ddanila/Pico1715/README.md

# Pico1715

An independent Pico-based replacement/expansion card for the Robotron PC 1715:
SD-backed virtual floppies, external RAM and a buffered X2 bus interface.
Original project code and design files are MIT licensed; see [LICENSE](LICENSE).

Configurable [compact triggers and rolling history](docs/analyzer-triggers.md) now
support event/address/data matching, bounded pre/post windows and USB download.

## Status

The scheduled-byte card model boots the unchanged classic ROM into SCP 0006 and
passes nine software regressions plus 36 latency/fault experiments.
See the [timing results](docs/timing-contract.md) and
[hardware requirements derived from them](hardware/timing-requirements.md).
The FPGA normal-I/O and interrupt frontend now passes all nine ROM/OS cases
in RTL co-simulation, including a shared-firmware profile with journaled SD
writeback. A 59-pin Olimex HX8K bench target is placed and routed,
and Pico Plus 2 firmware builds with PSRAM, SD CRC checking and optional journaled
writeback. See the [prototype build, wiring and parts guide](hardware/prototype.md).

**Bench prototype, not ready to manufacture:** no firmware has run on hardware,
no X2 electrical measurements have been made, and no qualified PCB exists.
The firmware co-simulator compiles the same service loop and journal code for
host execution and connects them to the board-level RTL. GPIO, time, PSRAM and
SD blocks are simulated; this does not execute RP2350 instructions or qualify
physical timing. See [firmware co-simulation](docs/firmware-cosim.md) and
[delayed storage, reset and recovery qualification](docs/firmware-storage-faults.md).

The standalone [analyzer transport](docs/analyzer-transport.md) now joins passive
FPGA cycle capture to a CRC-protected Pico link and a bounded 7 MiB PSRAM buffer.
Shared-firmware/RTL tests cover stalls, corruption, retry and buffer exhaustion;
stock-boot replay retains all 215,848 selected records. [USB control/download](docs/analyzer-usb.md)
now provides explicit arm/stop and validated capture files through a Python host
utility. A separate [passive analyzer adapter](hardware/analyzer-interface/README.md)
now has a checked schematic, full input harness and routed HX8K bitstream.
A [combined carrier schematic](hardware/carrier/README.md) now provides one
wiring contract for both personalities, a physical passive-mode interlock,
Pico power isolation, SD and button/SAFE-LED support. Both new FPGA targets route
with passing internal timing. Physical assembly, USB/timing qualification and
PCB layout remain open.

An experimental third [combined controller/capture personality](docs/combined-mode.md)
now runs disk service and finite analyzer capture concurrently. Classic CP/M guest
write/cold-read tests preserve existing files, and the HX8K build meets its
internal clock constraints. Capture loss under load is explicitly reported.
The optional [reserve supervisor](docs/reserve-interface.md) uses PIM724 SP/CE
GPIO32/33/36 and defaults to zero qualified energy. See the
[Rev A order gates](docs/rev-a-release.md) for remaining PCB work.

The first compatibility target is the **ordinary PC 1715**, retaining its boot
ROM and operating-system floppy routines. It must not be confused with the
**1715W/M**: the existing DAC emulator and available S550/TOS/M reference boot
exercise the latter's 8272-based controller. They are useful infrastructure,
not evidence that the ordinary 1715 controller has been implemented.
The owner's MB001 inventory identifies an ordinary 1715. Its board revision,
connector orientation and electrical behavior still require physical verification.

## Run the existing emulator baseline

Requirements: Python 3.10+, a C11 compiler, Git, and the external
[dac-emulation](https://github.com/ddanila/dac-emulation) checkout at the revision
recorded in [sources.json](docs/sources.json). No Python packages are required.

```sh
python3 tools/capture_dac.py \
  --dac ../dac-emulation \
  --rom ../dac/public/media/robotron/s550.bin \
  --prom ../dac/public/media/robotron/cas.bin \
  --disk ../dac/public/media/robotron/tosm10.img \
  --out local/wm-baseline
python3 -m unittest discover -s tests -v
```

The tool builds its adapter and the external emulator in this project's ignored
`build/` directory. It requires the pinned revision and clean tracked dependency
files. Inputs are read-only; the output directory must not already exist.
It records input hashes, emulator identity, I/O and interrupt-acknowledge events,
a text screen, and a report. It exits unsuccessfully if the boot prompt is absent,
inputs change, or the trace is truncated. ROM and disk contents are not committed.
Even the local trace can contain guest data: it stays ignored by default.

This is an **observational W/M baseline**, not co-simulation with Pico1715.
Read/write events can repeat on consecutive emulated CPU ticks; they are not
necessarily distinct bus transactions. Timestamps are emulator scheduling ticks,
not qualified physical X2 signal edges.

[Controller USB](docs/controller-usb.md) provides status and safe eject without
a debugger, including initialization/storage diagnostics and a host CLI.

## Next milestones

The [roadmap](docs/roadmap.md) separates implemented desk work from hardware
qualification. Safe eject/reserve-aware shutdown, motherboard interrupt-chain
modelling, firmware cost/fault tests, and controller USB status/eject are implemented
and tested within their documented simulation limits.

Analyzer capture, filtering, triggers, PSRAM transport, USB download and decoding
are also implemented. The [combined carrier](hardware/carrier/README.md) has checked
controller/analyzer FPGA personalities and a physical passive-mode interlock.
[Remote-reset software](docs/analyzer-reset.md) exists for the optional standalone
accessory; that accessory remains electrically unqualified and is disabled on the
combined carrier because GP22 serves SD chip select. X1/X2's reset contact alone
does not reset the CPU on the documented motherboard.

The [carrier layout](hardware/carrier/mechanics.md) now has local bypass placement,
2,206 routed segments, 426 vias and ground pours on both copper layers. All placed
non-SD terminals are connected. KiCad DRC reports zero violations and **12 open
connections, all involving the held SD socket**. X2 remains unplaced. See the
[routing evidence](hardware/carrier/routing.md). This is not a fabrication release;
SD/X2 geometry, return-path and timing review, optional backup power, broader OS
coverage and physical tests remain open.

Physical milestones remain:

1. Assemble the selected bench modules and verify PSRAM, SD and FPGA programming.
2. Measure worst-case Pico mailbox latency and translated bus timing on a fixture.
3. Verify X2 orientation, priority-chain wiring and mechanics on the actual 1715;
   boot the unchanged ROM and repeat the read/write/persistence tests.
4. Freeze the schematic, route the PCB, run ERC/DRC, and review manufacturing
   outputs; qualify assembled prototypes before declaring RTM.

See [hardware requirements](hardware/requirements.md),
[modelling plan](docs/modelling.md), [classic controller contract](docs/classic-controller.md)
and [licensing/provenance](NOTICE.md). The initial passing W/M run is recorded in
[reports/wm-baseline.json](reports/wm-baseline.json); local reference identities
are listed in [docs/local-evidence.json](docs/local-evidence.json).

## Plain PC1715 model

The pinned DAC revision supplies `machines/robotron1715` (runtime kind 3) with
64 KB RAM, the original ROM overlay and native card callbacks. This repository's
`model/controller.c` attaches to it without changing the emulator or guest code.
The runner enables onboard CTC/SIO, feeds completed keyboard bytes into the SIO
receive FIFO and reads the text screen from RAM. See the
[stock-software qualification](docs/onboard-keyboard.md). Production firmware
uses a bounded [two-byte receive queue](docs/receive-elasticity.md) to handle
index/mark interrupt overlap; the standalone reference model defaults to one byte.
[Service-cost tests](docs/service-costs.md) now cover processing stalls, shared-lock
contention, watchdog release and recovery during SD writeback.
[Stock Z80 cost experiments](docs/cpu-service-costs.md) combine these delays with
boot, BDOS and persistence checks, preserving both passing and overloaded profiles.
[Receive read-ahead](docs/read-ahead.md) moves byte preparation into idle mailbox
time while retaining the same two-byte capacity.
[Transmit staging](docs/transmit-staging.md) acknowledges bounded byte capture
before processing, preserving serializer deadlines and CRC validation.
[Combined stress](docs/combined-stress.md) adds deterministic processing bursts,
variable SD write latency and index-interrupt offsets, with overload and remount checks.
[Interrupt fault isolation](docs/interrupt-fault-isolation.md) releases failed
controller IRQ ownership and bypasses the chain until reset.

```sh
make test
python3 tools/check_classic.py \
  --dac ../dac-emulation \
  --rom /path/r1715bt.bin \
  --disk /path/r1715.cpm \
  --out local/classic-check
```

The checker requires the ROM and SCP image hashes recorded in
[local-evidence.json](docs/local-evidence.json), and a fresh output directory.
Inputs are read-only; writes affect disposable copies. It tests original-image
boot/DIR, SAVE, persistence, a disk-loaded BDOS read/write workload, TYPE after
cold boot, deletion/persistence, write protection, and absent media. Model-only
contract tests also cover malformed writes and interrupt/reset behavior.

See [reports/classic-compatibility.json](reports/classic-compatibility.json) and
[the controller contract and remaining gaps](docs/classic-controller.md).
Use `--timed` for scheduled bytes, or `tools/check_timing.py` with the same
arguments for the full timing suite.
**Scheduled bytes are not an electrically qualified hardware design.** Generic
PIO modes, full motherboard peripherals, other formats and physical bus behavior
remain outside this qualification.

## Bench adapter and fixture

The [buffered adapter schematic](hardware/interface/README.md) includes hardware
output gating and dual-rail supervision. The [standalone FPGA/Pico fixture](hardware/bench-fixture.md)
checks 515 mailbox transactions, IRQ/vector/RETI and returns a UART result.
Both are bench artifacts: [X2 common contacts](hardware/x2-pinout.md) are now
source-checked and assigned, including original-controller IRQ direction. Physical
validation and connector footprint selection remain pending.

The [four-contact EFS test fixture](hardware/efs58-coupon/README.md) provides
printed holder STL/STEP files, a routed passive breakout PCB and fabrication
files. It lets us screen a modern loose socket before committing to a full
58-contact replacement. Mating fit still requires sacrificial-contact trials.

## Prototype validation

```sh
make test test-store test-frontend test-irq test-pico-top lint-frontend
python3 tools/check_classic.py --cosim --dac ../dac-emulation \
  --rom /path/r1715bt.bin --disk /path/r1715.cpm --out local/rtl-check
```

RTL co-simulation requires Verilator and a C++ compiler. See
[reports/rtl-compatibility.json](reports/rtl-compatibility.json) for the nine-case
result and source hashes, and [the prototype guide](hardware/prototype.md) for
FPGA and firmware builds. ROMs and disk images remain external.

The [classic 1715 trace decoder](docs/analyzer-decoder.md) provides controller
timelines, field CRC checks, configurable WAIT/gap diagnostics and reference
comparison for downloaded compact captures.

[Safe eject and shutdown](docs/shutdown.md) now drain the journal before reporting
safe, with optional reserve-gated writeback and deterministic outage tests.

[Motherboard interrupt-chain tests](docs/motherboard-interrupts.md) now exercise
the real controller with CTC/SIO priority, IM2 vectors, RETI and card isolation.

The latest [desk-work pass](docs/desk-completion.md) adds a provisional routed
58-contact X2 breakout, assembly/probe documentation, return-path screening with
23 extra ground stitches, and a 30-case external-media survey/persistence suite.
The separate [four-layer Rev A](hardware/carrier-reva/README.md) now uses the
drawing-checked Würth SD socket and host header, with zero ERC/DRC violations
and zero opens. Return-path closure, final manufacturing review, actual connector
fit and hardware qualification remain open.

Further desk work now includes [W-loader diagnosis](docs/boot-image-diagnosis.md),
[indexed multi-extent and disk-full tests](docs/pattern-media.md) on native and
shared-firmware/FPGA backends, and an [optional reserve-power schematic](hardware/backup-power/README.md).
The reserve remains a draft with no GPIO integration or measured hold-up guarantee.

The [browser workstation](docs/browser-workstation.md) builds model and firmware/RTL
WebAssembly sessions for the classic-1715 DAC museum exhibit.

[Session capture](docs/session-capture.md) connects both emulator backends to the
workbench. The [guided bring-up runner](docs/bringup-runner.md) collects staged,
hash-bound evidence; simulated rehearsal never qualifies hardware.
