ddanila/Pico1715/docs/modelling.md

# Modelling Pico1715

## Plain PC1715 integration

The pinned DAC revision provides `machines/robotron1715`: a headless Z80,
64 KB RAM, a 2 KB read-only ROM overlay with writes reaching underlying RAM,
and an external-card callback interface. Pico1715's `model/controller.c`
implements the card through that interface. It receives full I/O addresses,
read/write cycles, ticks, reset, IRQ acknowledgement and RETI, but has no access
to guest memory or instruction addresses. DAC now also supplies a deferred-I/O callback for transaction waits.

`tools/classic_probe.c` composes that motherboard with the card and a minimal
completed-byte keyboard source. Onboard CTC/SIO are enabled; E0/ASCII bytes
enter the real modeled receive FIFO, and guest code owns status, register setup
and data reads. See [the keyboard migration](onboard-keyboard.md). The
runner observes this SCP revision's screen RAM at F800h. It never patches guest
instructions, injects return values into registers, or bypasses BIOS/BDOS calls.
It records controller reads/writes/interrupt acknowledgements, exports a separate
disk copy, and captures RAM for inspection. Outputs use exclusive file creation.

`tools/check_classic.py` enforces the pinned clean DAC revision and exact ROM/SCP
hashes. Nine scenarios cover cold boot/DIR, SAVE, saved-file persistence, a
2,560-byte BDOS write/read/compare, TYPE after cold boot, deletion and its
persistence, write protection, and absent media. All writes use private copies.
It verifies hashes and independently parses the created files; a successful
process exit or an observed ROM jump alone is not the acceptance criterion.
See [the onboard-peripheral report](../reports/onboard-classic.json) and
[controller contract](classic-controller.md).

## Scheduled timing and its limits

The optional timed profile independently clocks receive and transmit bytes,
implements register backpressure through DAC transaction waits, and exposes
lost-byte/CRC/delay/reset faults. All nine scenarios pass in timed mode. See the
[timing contract](timing-contract.md) for evidence, 36 experiments, exact delay
semantics and remaining limitations.

Legacy functional mode remains a demand-driven comparison. Neither mode is a
flux or full PIO simulation. Field acquisition is synthetic, valid writes update
sectors atomically, and the WAIT adapter cannot qualify physical sampling edges.
SIO/CTC/CRT are not fully modelled. External-memory inhibition and DMA are not
implemented on the plain card seam. Connector identity, voltage translation,
power sequencing and physical bus timing remain separate qualification gates.

## Shared firmware and board-level RTL

The `--firmware-cosim` profile connects the production `firmware/service.c` and
`firmware/store.c` to the actual `pico1715_top` RTL, including the bidirectional
mailbox, vector mirrors, IRQ/RETI toggles and backend-ready gating. A host HAL
supplies GPIO, clock, PSRAM and SD blocks. See [the execution boundary, evidence
and reproduction commands](firmware-cosim.md). This closes the direct C-backend
bypass in the earlier RTL profile; it does not emulate the RP2350 instruction set.

## W/M baseline remains separate

`tools/dac_capture.c` observes the existing `robotron1715m` model running S550 and
TOS/M. The wrapper `tools/capture_dac.py` verifies dependency identity and input
hashes and records CPU/DMA-aware traces. This uses the W/M 8272 controller and
cannot validate the ordinary 1715's custom two-PIO controller.

The earlier [classic startup report](../reports/classic-startup.json) is retained
as a no-controller negative baseline. It reaches the ROM's controller-ready wait;
[the newer compatibility report](../reports/classic-compatibility.json) supplies
the positive evidence with the functional card attached.
