ddanila/Pico1715/reports/carrier-reva-inspection/F_FAULT.png

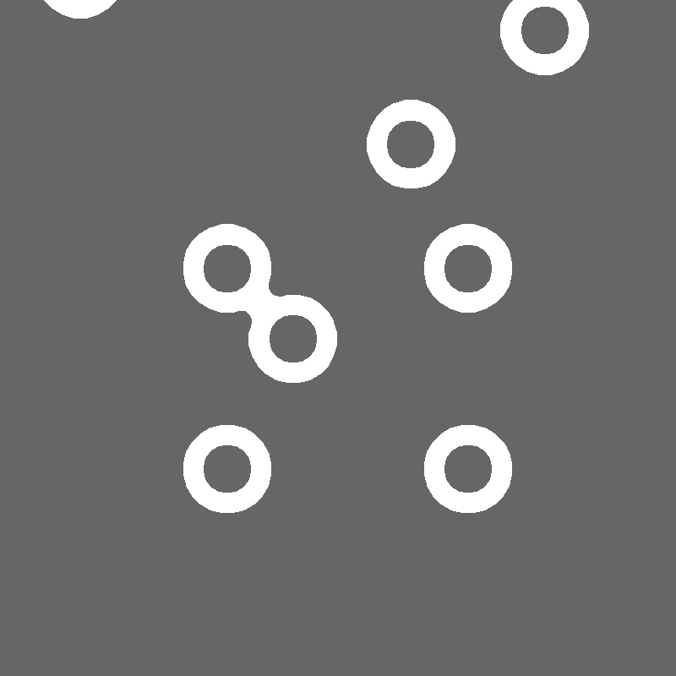
reports/carrier-reva-inspection/F_FAULT.png
