ddanila/Pico1715/reports/carrier-reva-inspection/F_WR_N.png

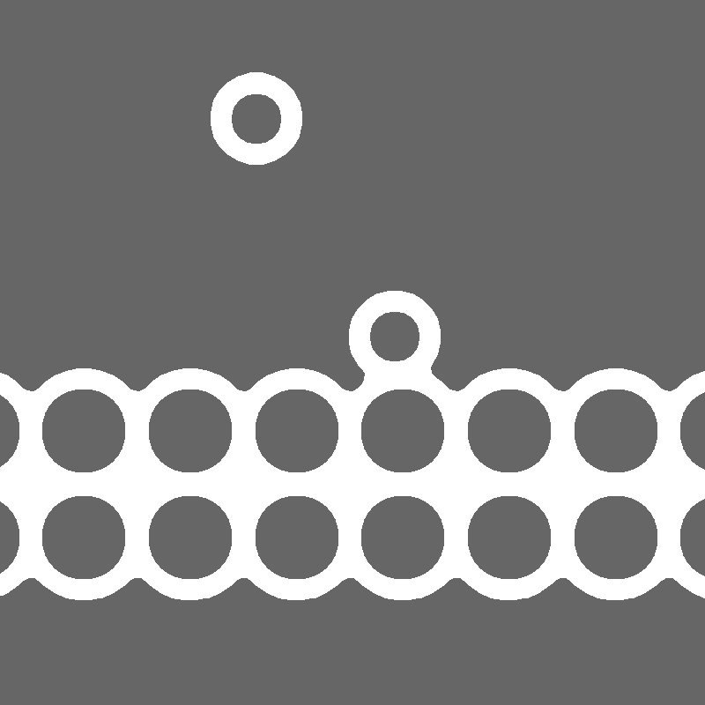
reports/carrier-reva-inspection/F_WR_N.png
