ddanila/Pico1715/reports/carrier-reva-inspection/P_VSYS.png

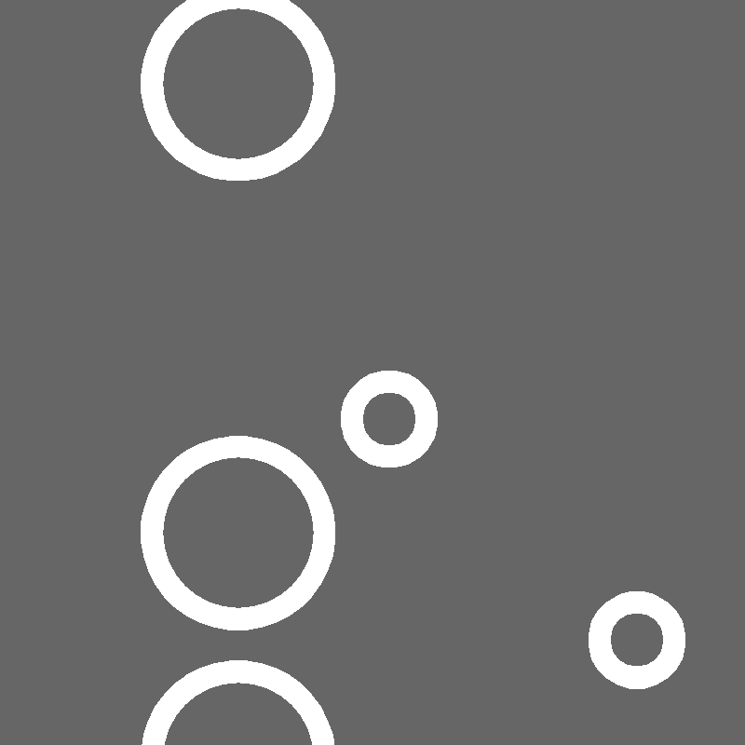
reports/carrier-reva-inspection/P_VSYS.png
