ddanila/Pico1715/reports/carrier-reva-inspection/SD_DAT1.png

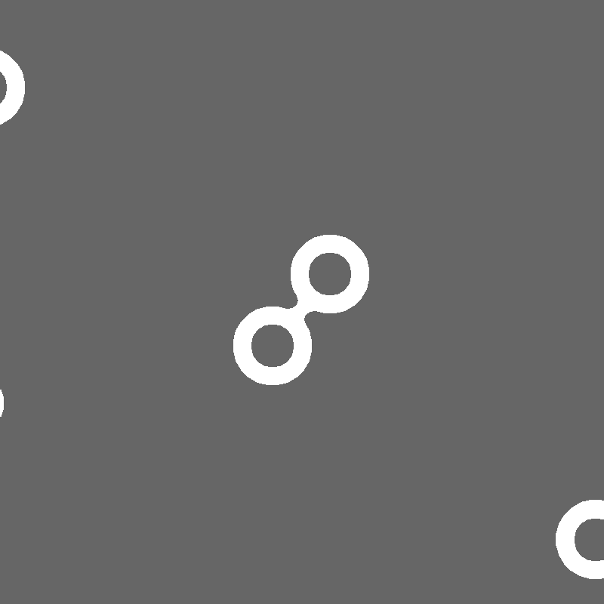
reports/carrier-reva-inspection/SD_DAT1.png
