ddanila/Pico1715/hardware/carrier-reva/bom.tsv

Reference | Value | Footprint | Datasheet
J6 | 61206021621_HOST_HARNESS | Pico1715_RevA:IDC_Wuerth_61206021621 | https://www.we-online.com/components/products/datasheet/61206021621.pdf
RX1 | SN74LVC541ADWR | Package_SO:SOIC-20W_7.5x12.8mm_P1.27mm | https://www.ti.com/lit/ds/symlink/sn74lvc541a.pdf
RX2 | SN74LVC541ADWR | Package_SO:SOIC-20W_7.5x12.8mm_P1.27mm | https://www.ti.com/lit/ds/symlink/sn74lvc541a.pdf
RX3 | SN74LVC541ADWR | Package_SO:SOIC-20W_7.5x12.8mm_P1.27mm | https://www.ti.com/lit/ds/symlink/sn74lvc541a.pdf
RX4 | SN74LVC541ADWR | Package_SO:SOIC-20W_7.5x12.8mm_P1.27mm | https://www.ti.com/lit/ds/symlink/sn74lvc541a.pdf
RX5 | SN74LVC541ADWR | Package_SO:SOIC-20W_7.5x12.8mm_P1.27mm | https://www.ti.com/lit/ds/symlink/sn74lvc541a.pdf
U4 | SN74AHCT541DWR | Package_SO:SOIC-20W_7.5x12.8mm_P1.27mm | https://www.ti.com/lit/ds/symlink/sn74ahct541.pdf
U5 | SN74AHCT1G125DBVR | Package_TO_SOT_SMD:SOT-23-5 | https://www.ti.com/lit/ds/symlink/sn74ahct1g125.pdf
U6 | SN74LVC08ADR | Package_SO:SOIC-14_3.9x8.7mm_P1.27mm | https://www.ti.com/lit/ds/symlink/sn74lvc08a.pdf
U7 | SN74LVC08ADR | Package_SO:SOIC-14_3.9x8.7mm_P1.27mm | https://www.ti.com/lit/ds/symlink/sn74lvc08a.pdf
U8 | SN74LVC00ADR | Package_SO:SOIC-14_3.9x8.7mm_P1.27mm | https://www.ti.com/lit/ds/symlink/sn74lvc00a.pdf
U13 | SN74LVC00ADR | Package_SO:SOIC-14_3.9x8.7mm_P1.27mm | https://www.ti.com/lit/ds/symlink/sn74lvc00a.pdf
U9 | SN74LVC07ADR | Package_SO:SOIC-14_3.9x8.7mm_P1.27mm | https://www.ti.com/lit/ds/symlink/sn74lvc07a.pdf
U10 | TLV803EA30DBZR | Package_TO_SOT_SMD:SOT-23 | https://www.ti.com/lit/ds/symlink/tlv803e.pdf
U11 | TLV803EA46DBZR | Package_TO_SOT_SMD:SOT-23 | https://www.ti.com/lit/ds/symlink/tlv803e.pdf
U12 | TLV803EA30DBZR | Package_TO_SOT_SMD:SOT-23 | https://www.ti.com/lit/ds/symlink/tlv803e.pdf
SW1 | JS202011JCQN | Pico1715_Carrier:JS202011JCQN_VendorPins | https://www.littelfuse.com/products/switches/slide-switches/js
ISO1 | SN74CB3Q3245PWR | Package_SO:TSSOP-20_4.4x6.5mm_P0.65mm | https://www.ti.com/lit/ds/symlink/sn74cb3q3245.pdf
ISO2 | SN74CB3Q3245PWR | Package_SO:TSSOP-20_4.4x6.5mm_P0.65mm | https://www.ti.com/lit/ds/symlink/sn74cb3q3245.pdf
ISO3 | SN74CB3Q3245PWR | Package_SO:TSSOP-20_4.4x6.5mm_P0.65mm | https://www.ti.com/lit/ds/symlink/sn74cb3q3245.pdf
EXT1 | OLIMEX_EXT1 | Connector_PinHeader_1.27mm:PinHeader_2x20_P1.27mm_Vertical | -
EXT2 | OLIMEX_EXT2 | Connector_PinHeader_1.27mm:PinHeader_2x20_P1.27mm_Vertical | -
EXT3 | OLIMEX_EXT3 | Connector_PinHeader_1.27mm:PinHeader_2x20_P1.27mm_Vertical | -
J1 | PGM1_PIN5_CDONE_TAP | Connector_PinHeader_2.54mm:PinHeader_1x02_P2.54mm_Vertical | -
J2 | PIM724_PICO_PLUS2 | Pico1715_Carrier:PIM724_SocketPair | https://shop.pimoroni.com/products/pimoroni-pico-plus-2
J3 | 693071010811 | Pico1715_RevA:microSD_Wuerth_693071010811 | https://www.we-online.com/components/products/datasheet/693071010811.pdf
J4 | REGULATED_5V_INPUT | Connector_JST:JST_XH_B2B-XH-A_1x02_P2.50mm_Vertical | -
D1 | SS14 | Diode_SMD:D_SMA | https://www.vishay.com/docs/88746/ss12.pdf
J5 | BRINGUP_PROBES | Connector_PinHeader_2.54mm:PinHeader_1x15_P2.54mm_Vertical | -
R1 | 2k2 | Resistor_SMD:R_0805_2012Metric | -
R2 | 22k | Resistor_SMD:R_0805_2012Metric | -
R3 | 2k2 | Resistor_SMD:R_0805_2012Metric | -
R4 | 22k | Resistor_SMD:R_0805_2012Metric | -
R5 | 2k2 | Resistor_SMD:R_0805_2012Metric | -
R6 | 22k | Resistor_SMD:R_0805_2012Metric | -
R7 | 4k7 | Resistor_SMD:R_0805_2012Metric | -
R8 | 4k7 | Resistor_SMD:R_0805_2012Metric | -
R9 | 4k7 | Resistor_SMD:R_0805_2012Metric | -
R10 | 4k7 | Resistor_SMD:R_0805_2012Metric | -
R11 | 4k7 | Resistor_SMD:R_0805_2012Metric | -
R12 | 4k7 | Resistor_SMD:R_0805_2012Metric | -
R13 | 4k7 | Resistor_SMD:R_0805_2012Metric | -
R14 | 1k | Resistor_SMD:R_0805_2012Metric | -
R15 | 1k | Resistor_SMD:R_0805_2012Metric | -
R16 | 100k | Resistor_SMD:R_0805_2012Metric | -
R17 | 4k7 | Resistor_SMD:R_0805_2012Metric | -
R18 | 10k | Resistor_SMD:R_0805_2012Metric | -
R19 | 4k7 | Resistor_SMD:R_0805_2012Metric | -
R20 | 4k7 | Resistor_SMD:R_0805_2012Metric | -
R21 | 4k7 | Resistor_SMD:R_0805_2012Metric | -
R22 | 47k | Resistor_SMD:R_0805_2012Metric | -
R23 | 47k | Resistor_SMD:R_0805_2012Metric | -
R24 | 47k | Resistor_SMD:R_0805_2012Metric | -
C1 | 100nF | Capacitor_SMD:C_0805_2012Metric | -
C2 | 100nF | Capacitor_SMD:C_0805_2012Metric | -
C3 | 100nF | Capacitor_SMD:C_0805_2012Metric | -
C4 | 100nF | Capacitor_SMD:C_0805_2012Metric | -
C5 | 100nF | Capacitor_SMD:C_0805_2012Metric | -
C6 | 100nF | Capacitor_SMD:C_0805_2012Metric | -
C7 | 100nF | Capacitor_SMD:C_0805_2012Metric | -
C8 | 100nF | Capacitor_SMD:C_0805_2012Metric | -
C9 | 100nF | Capacitor_SMD:C_0805_2012Metric | -
C10 | 100nF | Capacitor_SMD:C_0805_2012Metric | -
C11 | 100nF | Capacitor_SMD:C_0805_2012Metric | -
C12 | 100nF | Capacitor_SMD:C_0805_2012Metric | -
C13 | 100nF | Capacitor_SMD:C_0805_2012Metric | -
C14 | 100nF | Capacitor_SMD:C_0805_2012Metric | -
C15 | 100nF | Capacitor_SMD:C_0805_2012Metric | -
C16 | 100nF | Capacitor_SMD:C_0805_2012Metric | -
C17 | 100nF | Capacitor_SMD:C_0805_2012Metric | -
C18 | 100nF | Capacitor_SMD:C_0805_2012Metric | -
C19 | 100nF | Capacitor_SMD:C_0805_2012Metric | -
C20 | 10uF_10V | Capacitor_SMD:C_0805_2012Metric | -
C21 | 10uF_10V | Capacitor_SMD:C_0805_2012Metric | -
C22 | 10uF_10V | Capacitor_SMD:C_0805_2012Metric | -
J7 | B3B-XH-A_RESERVE_POWER | Connector_JST:JST_XH_B3B-XH-A_1x03_P2.50mm_Vertical | https://www.jst-mfg.com/product/index.php?series=277
