ddanila/Pico1715/hardware/analyzer-interface/bom.tsv

Reference | Value | Footprint | Datasheet
X2 | PC1715_X2_ANALYZER | - | -
U1 | SN74LVC541ADWR | Package_SO:SOIC-20W_7.5x12.8mm_P1.27mm | https://www.ti.com/lit/ds/symlink/sn74lvc541a.pdf
U2 | SN74LVC541ADWR | Package_SO:SOIC-20W_7.5x12.8mm_P1.27mm | https://www.ti.com/lit/ds/symlink/sn74lvc541a.pdf
U3 | SN74LVC541ADWR | Package_SO:SOIC-20W_7.5x12.8mm_P1.27mm | https://www.ti.com/lit/ds/symlink/sn74lvc541a.pdf
U4 | SN74LVC541ADWR | Package_SO:SOIC-20W_7.5x12.8mm_P1.27mm | https://www.ti.com/lit/ds/symlink/sn74lvc541a.pdf
U5 | SN74LVC541ADWR | Package_SO:SOIC-20W_7.5x12.8mm_P1.27mm | https://www.ti.com/lit/ds/symlink/sn74lvc541a.pdf
U6 | TLV803EA30DBZR | Package_TO_SOT_SMD:SOT-23 | https://www.ti.com/lit/ds/symlink/tlv803e.pdf
R1 | 0R | Resistor_SMD:R_0805_2012Metric | -
R2 | 10k | Resistor_SMD:R_0805_2012Metric | -
R3 | 2k2 | Resistor_SMD:R_0805_2012Metric | -
R4 | 22k | Resistor_SMD:R_0805_2012Metric | -
R5 | 4k7 | Resistor_SMD:R_0805_2012Metric | -
R6 | 4k7 | Resistor_SMD:R_0805_2012Metric | -
R7 | 4k7 | Resistor_SMD:R_0805_2012Metric | -
R8 | 4k7 | Resistor_SMD:R_0805_2012Metric | -
C1 | 100nF | Capacitor_SMD:C_0805_2012Metric | -
C2 | 100nF | Capacitor_SMD:C_0805_2012Metric | -
C3 | 100nF | Capacitor_SMD:C_0805_2012Metric | -
C4 | 100nF | Capacitor_SMD:C_0805_2012Metric | -
C5 | 100nF | Capacitor_SMD:C_0805_2012Metric | -
C6 | 100nF | Capacitor_SMD:C_0805_2012Metric | -
EXT1 | OLIMEX_EXT1 | - | -
EXT2 | OLIMEX_EXT2 | - | -
EXT3 | OLIMEX_EXT3 | - | -
J1 | PICO_GPIO_LOGICAL | - | -
J2 | FPGA_3V3_POWER | - | -
