ddanila/Pico1715/hardware/interface/bom.tsv

Reference | Value | Footprint | Datasheet
U1 | SN74LVC245ADWR | Package_SO:SOIC-20W_7.5x12.8mm_P1.27mm | https://www.ti.com/lit/ds/symlink/sn74lvc245a.pdf
U2 | SN74LVC245ADWR | Package_SO:SOIC-20W_7.5x12.8mm_P1.27mm | https://www.ti.com/lit/ds/symlink/sn74lvc245a.pdf
U3 | SN74LVC245ADWR | Package_SO:SOIC-20W_7.5x12.8mm_P1.27mm | https://www.ti.com/lit/ds/symlink/sn74lvc245a.pdf
U4 | SN74AHCT541DWR | Package_SO:SOIC-20W_7.5x12.8mm_P1.27mm | https://www.ti.com/lit/ds/symlink/sn74ahct541.pdf
U5 | SN74AHCT1G125DBVR | Package_TO_SOT_SMD:SOT-23-5 | https://www.ti.com/lit/ds/symlink/sn74ahct1g125.pdf
U6 | SN74LVC08ADR | Package_SO:SOIC-14_3.9x8.7mm_P1.27mm | https://www.ti.com/lit/ds/symlink/sn74lvc08a.pdf
U7 | SN74LVC08ADR | Package_SO:SOIC-14_3.9x8.7mm_P1.27mm | https://www.ti.com/lit/ds/symlink/sn74lvc08a.pdf
U8 | SN74LVC00ADR | Package_SO:SOIC-14_3.9x8.7mm_P1.27mm | https://www.ti.com/lit/ds/symlink/sn74lvc00a.pdf
U9 | SN74LVC07ADR | Package_SO:SOIC-14_3.9x8.7mm_P1.27mm | https://www.ti.com/lit/ds/symlink/sn74lvc07a.pdf
U10 | TLV803EA30DBZR | Package_TO_SOT_SMD:SOT-23 | https://www.ti.com/lit/ds/symlink/tlv803e.pdf
U11 | TLV803EA46DBZR | Package_TO_SOT_SMD:SOT-23 | https://www.ti.com/lit/ds/symlink/tlv803e.pdf
J1 | HOST_ADDRESS | - | -
J2 | HOST_DATA | - | -
J3 | HOST_CONTROL | - | -
J4 | FPGA_ADDRESS | - | -
J5 | FPGA_DATA_IN | - | -
J6 | FPGA_DATA_OUT | - | -
J7 | FPGA_CONTROL | - | -
J8 | QUALIFIERS | - | -
J9 | EXTERNAL_RAILS | - | -
JP1 | ARM_SHUNT | - | -
J10 | SCOPE | - | -
X2 | PC1715_X2 | - | -
J11 | IRQ_PATCH | - | -
R15 | 10k | Resistor_SMD:R_0805_2012Metric | -
R16 | 0R | Resistor_SMD:R_0805_2012Metric | -
R17 | 0R | Resistor_SMD:R_0805_2012Metric | -
R1 | 2k2 | Resistor_SMD:R_0805_2012Metric | -
R2 | 22k | Resistor_SMD:R_0805_2012Metric | -
R3 | 2k2 | Resistor_SMD:R_0805_2012Metric | -
R4 | 22k | Resistor_SMD:R_0805_2012Metric | -
R5 | 1k | Resistor_SMD:R_0805_2012Metric | -
R6 | 1k | Resistor_SMD:R_0805_2012Metric | -
R7 | 4k7 | Resistor_SMD:R_0805_2012Metric | -
R8 | 4k7 | Resistor_SMD:R_0805_2012Metric | -
R9 | 4k7 | Resistor_SMD:R_0805_2012Metric | -
R10 | 4k7 | Resistor_SMD:R_0805_2012Metric | -
R11 | 4k7 | Resistor_SMD:R_0805_2012Metric | -
R12 | 4k7 | Resistor_SMD:R_0805_2012Metric | -
R13 | 4k7 | Resistor_SMD:R_0805_2012Metric | -
R14 | 4k7 | Resistor_SMD:R_0805_2012Metric | -
C1 | 100nF | Capacitor_SMD:C_0805_2012Metric | -
C2 | 100nF | Capacitor_SMD:C_0805_2012Metric | -
C3 | 100nF | Capacitor_SMD:C_0805_2012Metric | -
C4 | 100nF | Capacitor_SMD:C_0805_2012Metric | -
C5 | 100nF | Capacitor_SMD:C_0805_2012Metric | -
C6 | 100nF | Capacitor_SMD:C_0805_2012Metric | -
C7 | 100nF | Capacitor_SMD:C_0805_2012Metric | -
C8 | 100nF | Capacitor_SMD:C_0805_2012Metric | -
C9 | 100nF | Capacitor_SMD:C_0805_2012Metric | -
C10 | 100nF | Capacitor_SMD:C_0805_2012Metric | -
C11 | 100nF | Capacitor_SMD:C_0805_2012Metric | -
