ddanila/Pico1715/hardware/efs58-coupon/assembly.step

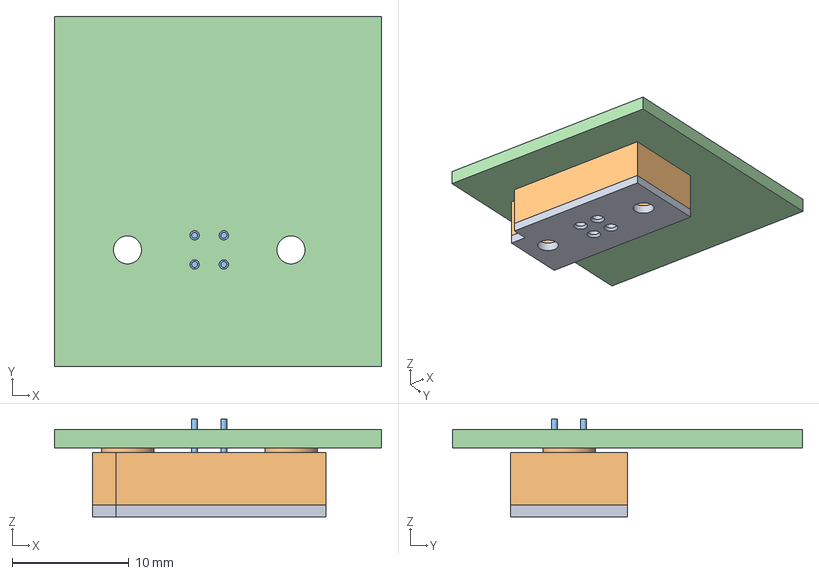
[picture p5: CAD file, 2026-10-26]
hardware/efs58-coupon/assembly.step
28.0 x 30.0 x 8.37 mm
