ddanila/Pico1715/hardware/efs58-coupon/front.step

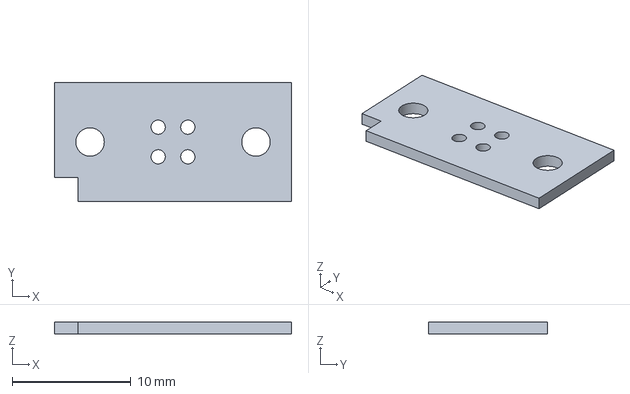
[picture p7: CAD file, 2026-10-26]
hardware/efs58-coupon/front.step
20.0 x 10.0 x 1.00 mm
