ddanila/Pico1715/hardware/efs58-coupon/body_c35.step

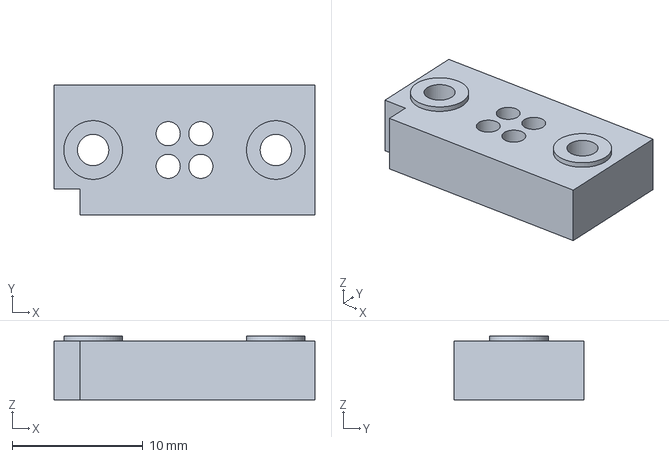
[picture p8: CAD file, 2026-10-26]
hardware/efs58-coupon/body_c35.step
20.0 x 10.0 x 4.90 mm
