ddanila/Pico1715/(list of files, cad)

Other CAD files:
hardware/efs58-coupon/body_c15.step
hardware/efs58-coupon/body_c15.stl
hardware/efs58-coupon/body_c25.stl
hardware/efs58-coupon/body_c35.stl
hardware/efs58-coupon/front.stl
