ddanila/Pico1715/(list of files, drawings)

Other design files:
hardware/carrier-reva/pcb-review.json
hardware/carrier/pcb-placement.json
