ddanila/Pico1715/hardware/carrier-reva/carrier.kicad_pcb

## KiCad design hardware/carrier-reva/carrier.kicad_pcb (2026-10-28)

Schematic: carrier.kicad_sch

Parts:
C1, C2, C3, C4, C5, C6, C7, C8, C9, C10, C11, C12, C13, C14, C15, C16, C17, C18, C19: 100nF; C_0805_2012Metric
C20, C21, C22: 10uF_10V; C_0805_2012Metric
D1: SS14; D_SMA
EXT1: OLIMEX_EXT1; PinHeader_2x20_P1.27mm_Vertical
EXT2: OLIMEX_EXT2; PinHeader_2x20_P1.27mm_Vertical
EXT3: OLIMEX_EXT3; PinHeader_2x20_P1.27mm_Vertical
ISO1, ISO2, ISO3: SN74CB3Q3245PWR; TSSOP-20_4.4x6.5mm_P0.65mm
J1: PGM1_PIN5_CDONE_TAP; PinHeader_1x02_P2.54mm_Vertical
J2: PIM724_PICO_PLUS2; PIM724_SocketPair
J3: 693071010811; microSD_Wuerth_693071010811
J4: REGULATED_5V_INPUT; JST_XH_B2B-XH-A_1x02_P2.50mm_Vertical
J5: BRINGUP_PROBES; PinHeader_1x15_P2.54mm_Vertical
J6: 61206021621_HOST_HARNESS; IDC_Wuerth_61206021621
J7: B3B-XH-A_RESERVE_POWER; JST_XH_B3B-XH-A_1x03_P2.50mm_Vertical
R1, R3, R5: 2k2; R_0805_2012Metric
R2, R4, R6: 22k; R_0805_2012Metric
R7, R8, R9, R10, R11, R12, R13, R17, R19, R20, R21: 4k7; R_0805_2012Metric
R14, R15: 1k; R_0805_2012Metric
R16: 100k; R_0805_2012Metric
R18: 10k; R_0805_2012Metric
R22, R23, R24: 47k; R_0805_2012Metric
RX1, RX2, RX3, RX4, RX5: SN74LVC541ADWR; SOIC-20W_7.5x12.8mm_P1.27mm
SW1: JS202011JCQN; JS202011JCQN_VendorPins
U4: SN74AHCT541DWR; SOIC-20W_7.5x12.8mm_P1.27mm
U5: SN74AHCT1G125DBVR; SOT-23-5
U6, U7: SN74LVC08ADR; SOIC-14_3.9x8.7mm_P1.27mm
U8, U13: SN74LVC00ADR; SOIC-14_3.9x8.7mm_P1.27mm
U9: SN74LVC07ADR; SOIC-14_3.9x8.7mm_P1.27mm
U10, U12: TLV803EA30DBZR; SOT-23
U11: TLV803EA46DBZR; SOT-23

Connections:
/ARMED: J5.9 (ARMED), U7.11 (4Y), U8.1 (1A), U8.4 (2A), U8.9 (3A), U8.12 (4A), U8.13 (4B)
/BACKEND_OK: U7.6 (2Y), U7.9 (3A)
/CDONE: J1.1 (CDONE_FROM_PGM1_5), J5.5 (CDONE), R16.1, U6.10 (3B)
/DATA_EN_N: U8.3 (1Y), U9.1 (1A)
/DATA_OE_N: J5.10 (DATA_OE_N), R14.2, U4.19 (OE2_N), U9.2 (1Y)
/DRIVEN_IEO: SW1.7 (CONTROLLER_IEO), U5.4 (Y)
/F_A0: EXT1.7 (F_A0), RX1.18 (Y0)
/F_A1: EXT1.9 (F_A1), RX1.17 (Y1)
/F_A2: EXT1.11 (F_A2), RX1.16 (Y2)
/F_A3: EXT1.13 (F_A3), RX1.15 (Y3)
/F_A4: EXT1.15 (F_A4), RX1.14 (Y4)
/F_A5: EXT1.17 (F_A5), RX1.13 (Y5)
/F_A6: EXT1.19 (F_A6), RX1.12 (Y6)
/F_A7: EXT1.21 (F_A7), RX1.11 (Y7)
/F_A8: EXT2.15 (F_A8), RX2.18 (Y0)
/F_A9: EXT2.17 (F_A9), RX2.17 (Y1)
/F_A10: EXT2.19 (F_A10), RX2.16 (Y2)
/F_A11: EXT2.21 (F_A11), RX2.15 (Y3)
/F_A12: EXT2.23 (F_A12), RX2.14 (Y4)
/F_A13: EXT2.25 (F_A13), RX2.13 (Y5)
/F_A14: EXT2.27 (F_A14), RX2.12 (Y6)
/F_A15: EXT2.29 (F_A15), RX2.11 (Y7)
/F_BAO_N: EXT2.40 (F_BAO_N), RX5.15 (Y3)
/F_BUSRQ_N: EXT2.39 (F_BUSRQ_N), RX5.16 (Y2)
/F_CLK: EXT2.33 (F_CLK), RX4.12 (Y6)
/F_D0: EXT1.23 (F_D0), RX3.18 (Y0)
/F_D1: EXT1.25 (F_D1), RX3.17 (Y1)
/F_D2: EXT1.27 (F_D2), RX3.16 (Y2)
/F_D3: EXT1.29 (F_D3), RX3.15 (Y3)
/F_D4: EXT1.31 (F_D4), RX3.14 (Y4)
/F_D5: EXT1.33 (F_D5), RX3.13 (Y5)
/F_D6: EXT1.35 (F_D6), RX3.12 (Y6)
/F_D7: EXT1.37 (F_D7), RX3.11 (Y7)
/F_DO0: EXT1.39 (F_DO0), U4.2 (A0)
/F_DO1: EXT1.40 (F_DO1), U4.3 (A1)
/F_DO2: EXT1.38 (F_DO2), U4.4 (A2)
/F_DO3: EXT1.36 (F_DO3), U4.5 (A3)
/F_DO4: EXT1.34 (F_DO4), U4.6 (A4)
/F_DO5: EXT1.32 (F_DO5), U4.7 (A5)
/F_DO6: EXT1.30 (F_DO6), U4.8 (A6)
/F_DO7: EXT1.28 (F_DO7), U4.9 (A7)
/F_FAULT: EXT2.13 (F_FAULT), J5.13 (F_FAULT)
/F_HOST_OE: EXT1.10 (F_HOST_OE), R10.1, U8.2 (1B)
/F_IEO: EXT2.11 (F_IEO), R13.1, U5.2 (A)
/F_INT: EXT2.9 (F_INT), R12.1, U8.10 (3B)
/F_INT_N: EXT2.37 (F_INT_N), RX5.17 (Y1)
/F_IORQ_N: EXT1.26 (F_IORQ_N), RX4.17 (Y1)
/F_M1_N: EXT1.24 (F_M1_N), RX4.14 (Y4)
/F_MREQ_N: EXT1.22 (F_MREQ_N), RX4.18 (Y0)
/F_PRIORITY: EXT1.16 (F_PRIORITY), RX5.14 (Y4)
/F_RD_N: EXT1.20 (F_RD_N), RX4.16 (Y2)
/F_RESET_N: EXT1.14 (F_RESET_N), ISO2.9 (A7), RX4.11 (Y7), U7.10 (3B)
/F_RFSH_N: EXT2.31 (F_RFSH_N), RX4.13 (Y5)
/F_WAIT: EXT2.7 (F_WAIT), R11.1, U8.5 (2B)
/F_WAIT_N: EXT2.35 (F_WAIT_N), RX5.18 (Y0)
/F_WR_N: EXT1.18 (F_WR_N), RX4.15 (Y3)
/GND: C1.2, C2.2, C3.2, C4.2, C5.2, C6.2, C7.2, C8.2, C9.2, C10.2, C11.2, C12.2, C13.2, C14.2, C15.2, C16.2, C17.2, C18.2, C19.2, C20.2, C21.2, C22.2, EXT1.2 (GND), EXT1.4 (GND), EXT1.8 (GND), EXT2.2 (GND), EXT2.4 (GND), EXT2.8 (GND), EXT3.2 (GND), EXT3.4 (GND), EXT3.8 (GND), ISO1.10 (GND), ISO2.10 (GND), ISO3.10 (GND), J1.2 (GND), J2.3 (GND), J2.8 (GND), J2.13 (GND), J2.18 (GND), J2.23 (GND), J2.28 (GND), J2.33 (GND), J2.38 (GND), J3.6 (VSS), J4.2 (GND), J5.1 (GND), J6.1 (0V), J6.2 (0V), J6.3 (0V), J6.4 (0V), J7.1 (GND), R2.2, R4.2, R6.2, R7.2, R8.2, R9.2, R10.2, R11.2, R12.2, R13.2, R16.2, R19.2, R20.2, RX1.1 (OE1_N), RX1.10 (GND), RX1.19 (OE2_N), RX2.1 (OE1_N), RX2.10 (GND), RX2.19 (OE2_N), RX3.1 (OE1_N), RX3.10 (GND), RX3.19 (OE2_N), RX4.1 (OE1_N), RX4.10 (GND), RX4.19 (OE2_N), RX5.1 (OE1_N), RX5.7 (A5), RX5.8 (A6), RX5.9 (A7), RX5.10 (GND), RX5.19 (OE2_N), SW1.1 (PASSIVE_GND), U4.1 (OE1_N), U4.10 (GND), U5.3 (GND), U6.7 (GND), U7.7 (GND), U8.7 (GND), U9.7 (GND), U10.1 (GND), U11.1 (GND), U12.1 (GND), U13.4 (2A), U13.5 (2B), U13.7 (GND), U13.9 (3A), U13.10 (3B), U13.12 (4A), U13.13 (4B)
/H_A0: J6.37 (AB0), RX1.2 (A0)
/H_A1: J6.38 (AB1), RX1.3 (A1)
/H_A2: J6.35 (AB2), RX1.4 (A2)
/H_A3: J6.36 (AB3), RX1.5 (A3)
/H_A4: J6.33 (AB4), RX1.6 (A4)
/H_A5: J6.34 (AB5), RX1.7 (A5)
/H_A6: J6.31 (AB6), RX1.8 (A6)
/H_A7: J6.32 (AB7), RX1.9 (A7)
/H_A8: J6.27 (AB8), RX2.2 (A0)
/H_A9: J6.28 (AB9), RX2.3 (A1)
/H_A10: J6.25 (AB10), RX2.4 (A2)
/H_A11: J6.26 (AB11), RX2.5 (A3)
/H_A12: J6.23 (AB12), RX2.6 (A4)
/H_A13: J6.24 (AB13), RX2.7 (A5)
/H_A14: J6.21 (AB14), RX2.8 (A6)
/H_A15: J6.22 (AB15), RX2.9 (A7)
/H_BAO_N: J6.53 (/BAO), RX5.5 (A3)
/H_BUSRQ_N: J6.40 (/BUSRQ), RX5.4 (A2)
/H_CLK: J6.41 (TAKT-X2), RX4.8 (A6)
/H_D0: J6.14 (DB0), RX3.2 (A0), U4.18 (Y0)
/H_D1: J6.13 (DB1), RX3.3 (A1), U4.17 (Y1)
/H_D2: J6.12 (DB2), RX3.4 (A2), U4.16 (Y2)
/H_D3: J6.11 (DB3), RX3.5 (A3), U4.15 (Y3)
/H_D4: J6.10 (DB4), RX3.6 (A4), U4.14 (Y4)
/H_D5: J6.9 (DB5), RX3.7 (A5), U4.13 (Y5)
/H_D6: J6.8 (DB6), RX3.8 (A6), U4.12 (Y6)
/H_D7: J6.7 (DB7), RX3.9 (A7), U4.11 (Y7)
/H_INT_N: J5.12 (H_INT_N), J6.46 (/INT), RX5.3 (A1), U9.6 (3Y)
/H_IORQ_N: J6.48 (/IORQ), RX4.3 (A1)
/H_M1_N: J6.51 (/M1), RX4.6 (A4)
/H_MREQ_N: J6.17 (/MREQ), RX4.2 (A0)
/H_PRIORITY: J6.20 (IEO), R18.2, RX5.6 (A4), SW1.5 (PASSIVE_IEI)
/H_PRIORITY_OUT: J6.19 (IEI), SW1.6 (COMMON_IEO)
/H_RD_N: J6.16 (/RD), RX4.4 (A2)
/H_RESET_N: J6.39 (/RESET), RX4.9 (A7)
/H_RFSH_N: J6.49 (/RFSH), RX4.7 (A5)
/H_WAIT_N: J5.11 (H_WAIT_N), J6.47 (/WAIT), RX5.2 (A0), U9.4 (2Y)
/H_WR_N: J6.15 (/WR), RX4.5 (A3)
/IEO_EN_N: U8.11 (4Y), U9.9 (4A)
/IEO_OE_N: R15.2, U5.1 (OE_N), U9.8 (4Y)
/INT_EN_N: U8.8 (3Y), U9.5 (3A)
/LINK_OE_N: ISO1.19 (OE_N), ISO2.19 (OE_N), ISO3.19 (OE_N), R17.2, U13.3 (1Y)
/LINK_OK: EXT3.29 (LINK_OK), J5.8 (LINK_OK), U6.8 (3Y), U6.13 (4B), U13.1 (1A), U13.2 (1B)
/L_GP0: EXT2.28 (L_GP0), ISO1.2 (A0)
/L_GP1: EXT2.26 (L_GP1), ISO1.3 (A1)
/L_GP2: EXT2.24 (L_GP2), ISO1.4 (A2)
/L_GP3: EXT2.22 (L_GP3), ISO1.5 (A3)
/L_GP4: EXT2.20 (L_GP4), ISO1.6 (A4)
/L_GP5: EXT2.18 (L_GP5), ISO1.7 (A5)
/L_GP6: EXT2.16 (L_GP6), ISO1.8 (A6)
/L_GP7: EXT2.14 (L_GP7), ISO1.9 (A7)
/L_GP8: EXT2.12 (L_GP8), ISO2.2 (A0)
/L_GP9: EXT2.10 (L_GP9), ISO2.3 (A1)
/L_GP10: EXT3.7 (L_GP10), ISO2.4 (A2)
/L_GP11: EXT3.9 (L_GP11), ISO2.5 (A3)
/L_GP12: EXT3.11 (L_GP12), ISO2.6 (A4)
/L_GP13: EXT3.13 (L_GP13), ISO2.7 (A5)
/L_GP14: EXT3.15 (L_GP14), ISO2.8 (A6), R19.1
/L_GP16: EXT3.17 (L_GP16), ISO3.2 (A0), R20.1
/L_GP17: EXT3.19 (L_GP17), ISO3.3 (A1), R21.1
/L_GP18: EXT3.21 (L_GP18), ISO3.4 (A2)
/L_GP19: EXT3.23 (L_GP19), ISO3.5 (A3)
/L_GP20: EXT3.25 (L_GP20), ISO3.6 (A4)
/L_GP21: EXT3.27 (L_GP21), ISO3.7 (A5), R9.1, U7.5 (2B)
/MODE_CTL: J5.6 (MODE_CTL), R7.1, SW1.2 (COMMON_MODE), U7.13 (4B)
/P3V3: C15.1, C19.1, C21.1, J2.36 (P3V3), J3.4 (VDD), J5.14 (P3V3), R5.1, R22.1, R23.1, R24.1, U12.3 (VDD)
/PERSONALITY_CTL: EXT2.38 (PERSONALITY_CTL), J5.7 (PERSONALITY_CTL), R8.1, U7.2 (1B)
/PG3: J5.2 (PG3), R1.2, R2.1, U6.1 (1A), U6.4 (2A), U10.2 (RESET_N)
/PG5: J5.3 (PG5), R3.2, R4.1, U6.2 (1B), U11.2 (RESET_N)
/PGP: J5.4 (PGP), R5.2, R6.1, U6.5 (2B), U12.2 (RESET_N)
/POWERED: U6.11 (4Y), U7.1 (1A)
/POWER_GOOD: EXT1.12 (POWER_GOOD), U6.3 (1Y), U6.12 (4A)
/P_GP0: ISO1.18 (B0), J2.1 (P_GP0)
/P_GP1: ISO1.17 (B1), J2.2 (P_GP1)
/P_GP2: ISO1.16 (B2), J2.4 (P_GP2)
/P_GP3: ISO1.15 (B3), J2.5 (P_GP3)
/P_GP4: ISO1.14 (B4), J2.6 (P_GP4)
/P_GP5: ISO1.13 (B5), J2.7 (P_GP5)
/P_GP6: ISO1.12 (B6), J2.9 (P_GP6)
/P_GP7: ISO1.11 (B7), J2.10 (P_GP7)
/P_GP8: ISO2.18 (B0), J2.11 (P_GP8)
/P_GP9: ISO2.17 (B1), J2.12 (P_GP9)
/P_GP10: ISO2.16 (B2), J2.14 (P_GP10)
/P_GP11: ISO2.15 (B3), J2.15 (P_GP11)
/P_GP12: ISO2.14 (B4), J2.16 (P_GP12)
/P_GP13: ISO2.13 (B5), J2.17 (P_GP13)
/P_GP14: ISO2.12 (B6), J2.19 (P_GP14)
/P_GP15: ISO2.11 (B7), J2.20 (P_GP15)
/P_GP16: ISO3.18 (B0), J2.21 (P_GP16)
/P_GP17: ISO3.17 (B1), J2.22 (P_GP17)
/P_GP18: ISO3.16 (B2), J2.24 (P_GP18)
/P_GP19: ISO3.15 (B3), J2.25 (P_GP19)
/P_GP20: ISO3.14 (B4), J2.26 (P_GP20)
/P_GP21: ISO3.13 (B5), J2.27 (P_GP21)
/P_GP22: J2.29 (P_GP22), J3.2 (DAT3_CS), R22.2
/P_GP26: J2.31 (P_GP26), J3.5 (CLK)
/P_GP27: J2.32 (P_GP27), J3.3 (CMD_MOSI)
/P_GP28: J2.34 (P_GP28), J3.7 (DAT0_MISO)
/P_VSYS: D1.1 (K), J2.39 (P_VSYS), J7.3 (BACKED_VSYS)
/QUALIFIED: U7.3 (1Y), U7.4 (2A)
/RAILS_OK: U6.6 (2Y), U6.9 (3A)
/RESET_OK: U7.8 (3Y), U7.12 (4A)
/SD_DAT1: J3.8 (DAT1), R23.2
/SD_DAT2: J3.1 (DAT2), R24.2
/V3P3: C1.1, C2.1, C3.1, C4.1, C5.1, C8.1, C9.1, C10.1, C11.1, C12.1, C13.1, C16.1, C17.1, C18.1, C20.1, EXT1.3 (V3P3), ISO1.20 (VCC), ISO2.20 (VCC), ISO3.20 (VCC), J5.15 (V3P3), R1.1, R17.1, R21.2, RX1.20 (VCC), RX2.20 (VCC), RX3.20 (VCC), RX4.20 (VCC), RX5.20 (VCC), SW1.3 (CONTROLLER_3V3), U6.14 (VCC), U7.14 (VCC), U8.14 (VCC), U9.11 (5A), U9.13 (6A), U9.14 (VCC), U10.3 (VDD), U13.14 (VCC)
/V5_HOST: C6.1, C7.1, C14.1, J6.57 (5P), J6.58 (5P), R3.1, R14.1, R15.1, R18.1, U4.20 (VCC), U5.5 (VCC), U11.3 (VDD)
/V5_MODULE: C22.1, D1.2 (A), EXT1.1 (V5_MODULE), J4.1 (5V), J7.2 (RAW_5V)
/WAIT_EN_N: U8.6 (2Y), U9.3 (2A)

Notes on the sheet:
Pico1715 Rev A / FOUR-LAYER CANDIDATE / NOT FOR FABRICATION
J6: straight-through 60-pin host harness; A=odd, B=even; 59/60 NC. Separate unqualified EFS58 adapter.
J7 reserve POWER only: 1 GND, 2 raw module 5V, 3 backed VSYS. Keep D1 fitted; optional daughter not included.
SD and connector drawing geometry checked; physical fit untested. RESET2 input only. Power off before mode or cable changes.

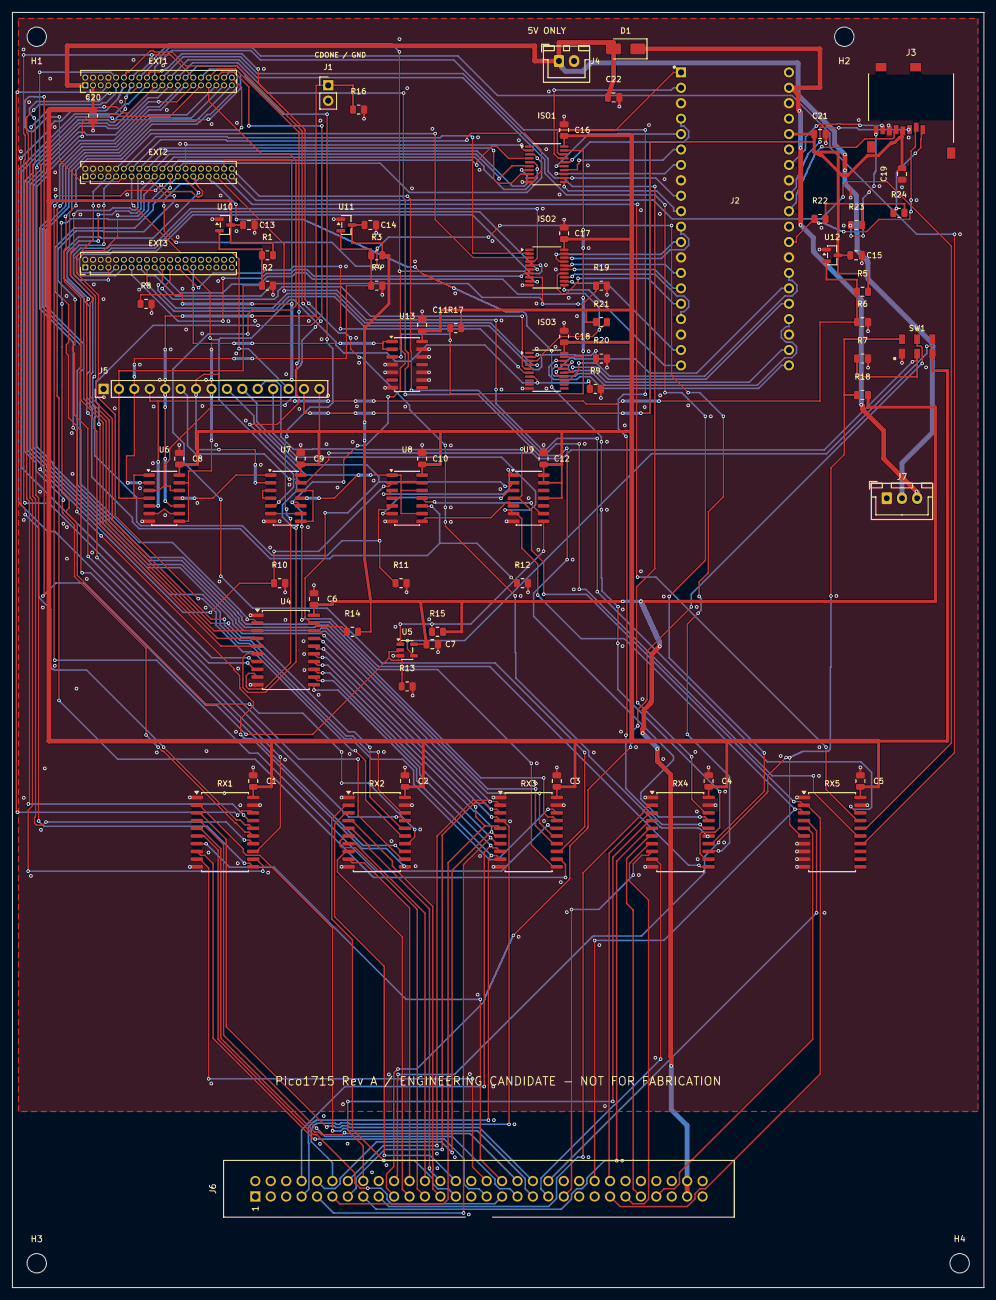
[picture p9: board carrier.kicad_pcb from above]

Board: 4 copper layers, 160.0 x 210.0 mm, 80 parts (0 on the bottom side), 165 nets.

Other parts of the board:
H1, H2, H3, H4: MountingHole_3.2mm_M3
