ddanila/Pico1715/hardware/efs58-coupon/coupon.kicad_pcb

## KiCad design hardware/efs58-coupon/coupon.kicad_pcb (2026-10-26)

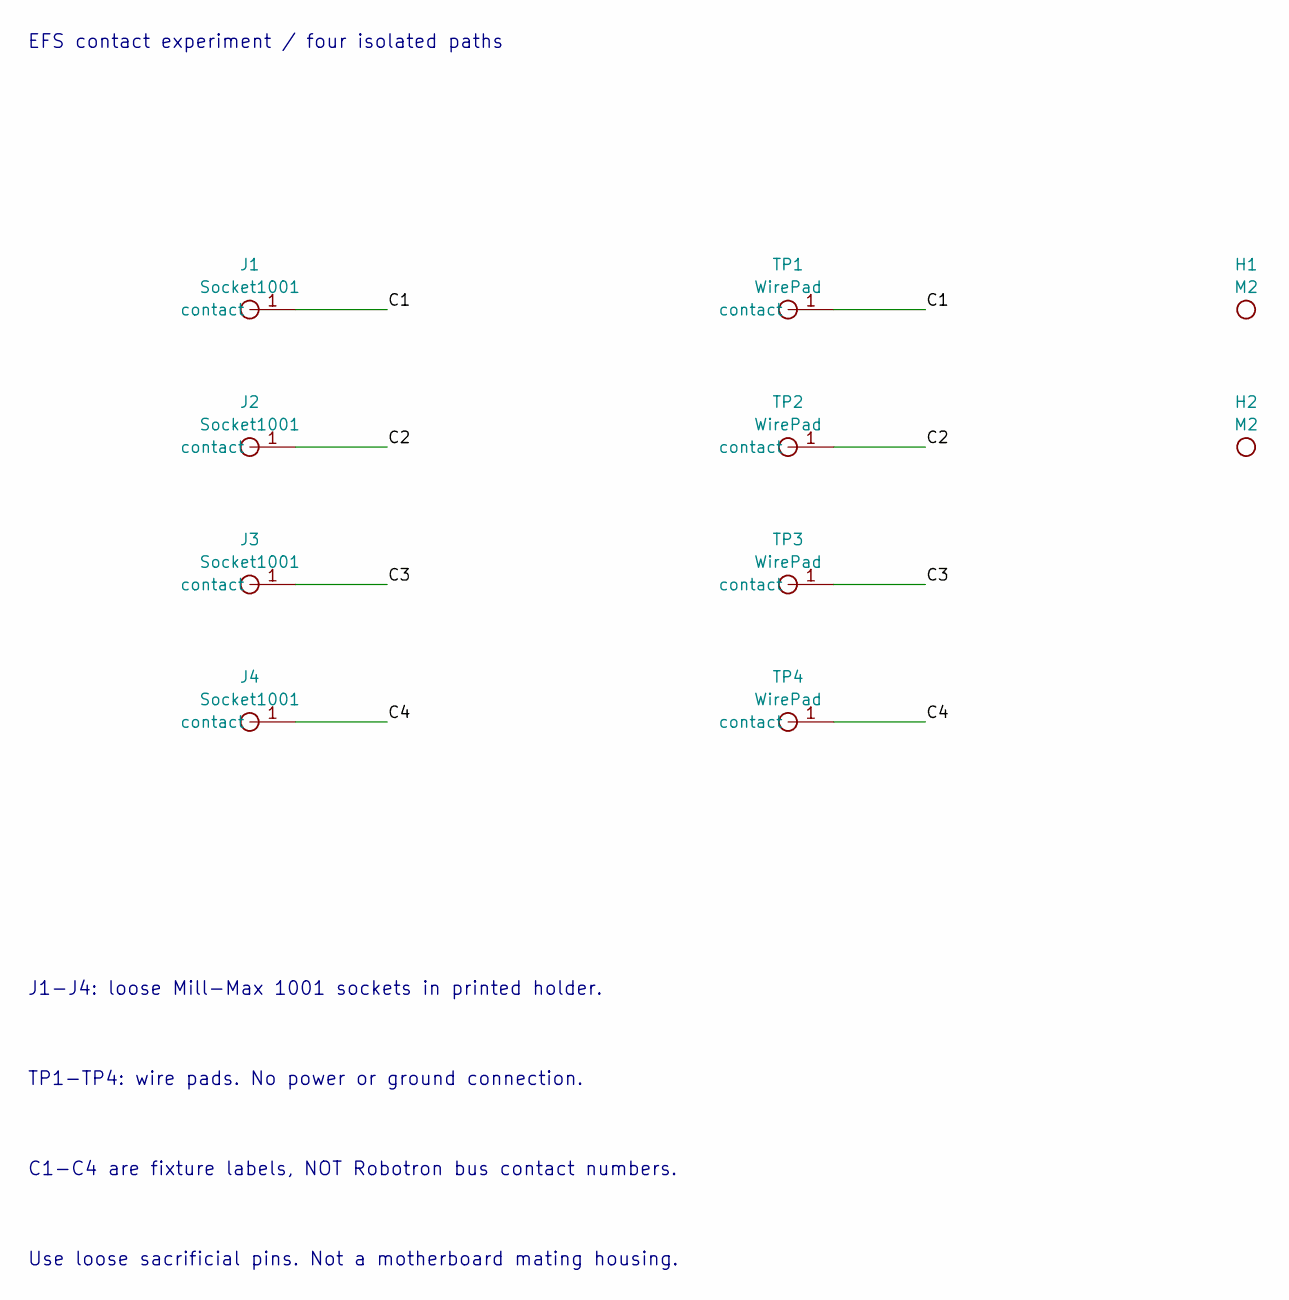
[picture p10: schematic coupon.kicad_sch]

Parts:
H1, H2: M2
J1, J2, J3, J4: Socket1001
TP1, TP2, TP3, TP4: WirePad

Connections:
/C1: J1.1, TP1.1
/C2: J2.1, TP2.1
/C3: J3.1, TP3.1
/C4: J4.1, TP4.1

Notes on the sheet:
EFS contact experiment / four isolated paths
J1-J4: loose Mill-Max 1001 sockets in printed holder.
TP1-TP4: wire pads. No power or ground connection.
C1-C4 are fixture labels, NOT Robotron bus contact numbers.
Use loose sacrificial pins. Not a motherboard mating housing.

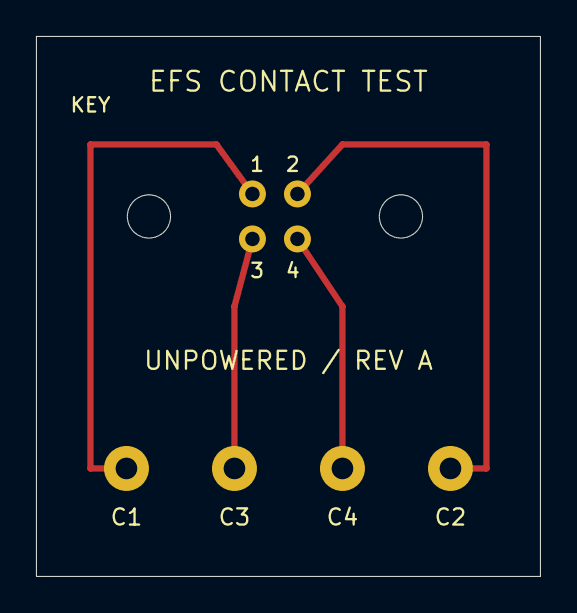
[picture p11: board coupon.kicad_pcb from above]

Board: 2 copper layers, 28.0 x 30.0 mm, 10 parts (0 on the bottom side), 4 nets.
