ddanila/Pico1715/hardware/boards/hx8k-carrier-controller.pcf

# Combined carrier A ONLY; power off before changing mode.
set_io clk100 J3
set_io host_addr[0] C14
set_io host_addr[1] B15
set_io host_addr[2] D13
set_io host_addr[3] B14
set_io host_addr[4] C12
set_io host_addr[5] E11
set_io host_addr[6] C13
set_io host_addr[7] A16
set_io host_din[0] A15
set_io host_din[1] B13
set_io host_din[2] E10
set_io host_din[3] C11
set_io host_din[4] D11
set_io host_din[5] B12
set_io host_din[6] B10
set_io host_din[7] B11
set_io host_dout[0] C10
set_io host_dout[1] A10
set_io host_dout[2] A11
set_io host_dout[3] D10
set_io host_dout[4] C9
set_io host_dout[5] E9
set_io host_dout[6] D9
set_io host_dout[7] A9
set_io iorq_n F9
set_io m1_n C8
set_io mreq_n F7
set_io rd_n B9
set_io wr_n D8
set_io iei B8
set_io host_reset_n A7
set_io power_good C7
set_io host_oe B7
set_io wait_pull_low B6
set_io int_pull_low C6
set_io ieo D7
set_io fault A6
set_io pico_data[0] P16
set_io pico_data[1] M13
set_io pico_data[2] M14
set_io pico_data[3] L12
set_io pico_data[4] N16
set_io pico_data[5] L13
set_io pico_data[6] L14
set_io pico_data[7] K12
set_io pico_reg[0] M16
set_io pico_reg[1] J10
set_io pico_reg[2] M15
set_io pico_reg[3] J11
set_io pico_write L16
set_io pico_request K13
set_io pico_ack K14
set_io pico_index J15
set_io pico_mark K15
set_io ack_toggle K16
set_io reti_toggle J14
set_io ack_index J12
set_io backend_ready J13
set_io personality_controller C3
