ddanila/Pico1715/firmware/analyzer.h

/* SPDX-License-Identifier: MIT */
#ifndef P1715_ANALYZER_H
#define P1715_ANALYZER_H
#include <stdbool.h>
#include <stddef.h>
#include <stdint.h>
#define P1715_LA_ACK (1u<<14)
#define P1715_LA_SYNC (1u<<16)
#define P1715_LA_CLEAR (1u<<17)
#define P1715_LA_RUN (1u<<21)
#define P1715_LA_CONTROLS (P1715_LA_ACK|P1715_LA_SYNC|P1715_LA_CLEAR|P1715_LA_RUN)
#define P1715_LA_RAM_OFFSET (1024u*1024u)
#define P1715_LA_RAM_SIZE (7u*1024u*1024u)
typedef struct {
 void *user;
 uint32_t (*pins)(void *);
 void (*controls)(void *,uint32_t);
 uint64_t (*time_us)(void *);
 void (*fence)(void *);
} p1715_analyzer_io;
enum {P1715_LA_HOLD=1,P1715_LA_REQUEST,P1715_LA_LOW,P1715_LA_DONE,P1715_LA_ERROR};
typedef struct {
 uint32_t enabled,kinds,address,data,pre,post;
} p1715_trigger_config;
typedef struct {
 p1715_trigger_config trigger;
 uint32_t head,omitted,trigger_index,trigger_sequence,post_collected,stop_reason;
 bool triggered;
 p1715_analyzer_io io;
 uint8_t *ram;
 size_t size;
 uint32_t state,controls,records,unique_records,local_dropped,fpga_dropped,filtered;
 uint32_t retries,duplicates,crc_errors,index_errors,clock_hz,last_sequence;
 bool stopping,full,have_last,terminal;
 unsigned received,consecutive_errors;
 uint64_t progress,release_at;
 uint8_t frame[22],last_record[16];
} p1715_analyzer;
int p1715_analyzer_start(p1715_analyzer *,p1715_analyzer_io,uint8_t *,size_t,uint32_t);
int p1715_analyzer_start_trigger(p1715_analyzer *,p1715_analyzer_io,uint8_t *,size_t,uint32_t,const p1715_trigger_config *);
bool p1715_trigger_valid(const p1715_trigger_config *,size_t);
size_t p1715_analyzer_header_size(const p1715_analyzer *);
void p1715_analyzer_trigger_info(const p1715_analyzer *,uint8_t *);
int p1715_analyzer_read(const p1715_analyzer *,uint32_t,uint8_t *,size_t);
void p1715_analyzer_step(p1715_analyzer *);
/* Core-owned complete frame ingress for the combined mailbox transport.
   Returns false on malformed evidence; no GPIO handshake is performed. */
bool p1715_analyzer_frame(p1715_analyzer *,const uint8_t frame[22]);
void p1715_analyzer_stop(p1715_analyzer *);
#endif
