ddanila/Pico1715/(commit log)

2026-10-25 Prototype and verify the normal-I/O bus frontend
2026-10-25 Build HX8K and Pico Plus 2 bench prototype with RTL co-simulation
2026-10-25 Add buffered bench adapter schematic and standalone Pico fixture
    [bench-interface.kicad_sch, bom.tsv]
2026-10-25 Assign documented X2 contacts and isolate disputed IRQ chain
    [bench-interface.kicad_sch, bom.tsv]
2026-10-25 Resolve classic X2 IRQ chain and audit bus timing on original drawings
    [bench-interface.kicad_sch, bom.tsv]
2026-10-25 Run shared Pico firmware against board-level RTL and stock 1715 software
2026-10-25 Qualify delayed SD writeback, host resets and journal power-loss recovery
    [bridge.cpp, build_firmware_faults.py, check_classic.py, check_firmware_faults.py, check_firmware_resets.py, classic_probe.c, firmware_faults.cpp, host_hal.c]
2026-10-26 Implement passive FPGA analyzer capture and trace export prototype
2026-10-26 Add recoverable analyzer link and bounded Pico PSRAM capture
2026-10-26 Integrate passive analyzer adapter and routed HX8K target
    [analyzer-interface.kicad_sch, bom.tsv]
2026-10-26 Add optional bounded reset and arm-reset analyzer workflow
    [analyzer_main.c, analyzer_usb.c, analyzer_usb.h, analyzer_usb.py, analyzer_usb_fixture.c, test_analyzer_usb.py, test_reset_pio.py]
2026-10-26 Qualify controller and motherboard interrupt chain against pinned emulator
2026-10-26 Route stock keyboard input through onboard SIO and expose timing collision
    [check_classic.py, check_onboard_keyboard.py, classic_probe.c, firmware_cosim_smoke.py, onboard_keyboard_smoke.py]
2026-10-26 Buffer transient index/mark receive overlap and qualify interrupt phases
2026-10-26 Measure firmware stall budgets and reject expired mailbox responses
    [build_firmware_faults.py, check_firmware_timing.py, firmware_timing.cpp, host_hal.c, host_hal.h, platform.h, service.c]
2026-10-26 Pipeline receive preparation and capture first byte-loss windows
    [read-ahead-after-read32.csv, read-ahead-after-write8.csv, read-ahead-before-read5.csv, read-ahead-before-write8.csv]
2026-10-26 Stage transmit bytes before processing and qualify stock writes
    [tx-staging-write32.csv]
2026-10-26 Qualify combined processing bursts, SD jitter and index phases
    [burst-initial-abort.csv, combined-stress-overload.csv]
2026-10-26 Isolate interrupt arbitration on latched mailbox faults
    [irq-isolation-overload.csv]
2026-10-26 Add combined controller and analyzer carrier schematic with passive interlock
    [bom.tsv, carrier.kicad_sch]
2026-10-26 Audit carrier footprints and add mechanical allocation study
    [bom.tsv, carrier.kicad_sch]
2026-10-26 Add unrouted carrier PCB and verify pad-to-schematic connectivity
    [bom.tsv, carrier.kicad_pcb, carrier.kicad_sch, pcb-placement.json]
2026-10-26 Add printable four-contact EFS socket test fixture and routed coupon
    [assembly.step, body_c15.step, body_c15.stl, body_c25.step, body_c25.stl, body_c35.step, body_c35.stl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]
2026-10-26 Route carrier bypass and module power sections and refresh roadmap
    [carrier.kicad_pcb, pcb-placement.json]
2026-10-26 Route carrier supervisor networks and resistor ground returns
    [carrier.kicad_pcb, pcb-placement.json]
2026-10-27 Distribute carrier power rails and route local control branches
    [carrier.kicad_pcb, pcb-placement.json]
2026-10-27 Route supervisor inputs and internal interlock gate paths
    [carrier.kicad_pcb, pcb-placement.json]
2026-10-27 Route isolator enables and link qualification inputs
    [carrier.kicad_pcb, pcb-placement.json]
2026-10-27 Complete carrier routing outside held SD and X2 connectors
    [carrier.kicad_pcb, pcb-placement.json]
2026-10-27 Add provisional X2 adapter, routing review and extended media qualification
    [adapter.kicad_pcb, adapter.kicad_sch, carrier.kicad_pcb, pcb-placement.json]
2026-10-27 Complete media diagnostics, storage stress tests and carrier desk review
    [backup.kicad_sch, carrier.kicad_pcb, pcb-placement.json]
2026-10-27 Add one-shot asynchronous keyboard schedules to native and firmware probes
2026-10-27 Build analyzer workbench fixtures, decoder oracles and WASM test seams
    [build_analyzer_workbench.py]
2026-10-27 Corrupt a payload byte in the CRC failure example
    [build_analyzer_workbench.py]
2026-10-27 Add scripted capture and staged bring-up evidence runner
2026-10-28 Add combined controller capture and optional reserve supervisor
    [backup.kicad_sch]
2026-10-28 Add routed four-layer Rev A carrier review candidate
    [bom.tsv, carrier.kicad_pcb, carrier.kicad_sch, pcb-review.json]
2026-10-28 Route Rev A SD socket and add drawing-checked fabrication review gates
    [bom.tsv, carrier.kicad_pcb, carrier.kicad_sch, pcb-review.json]
2026-10-28 Close Rev A return paths and bind fabrication review to exact exports
    [carrier.kicad_pcb, pcb-review.json]
